nozzletics/adventtree26/(list of files, cad)

Other CAD files:
3mf_profiles/AdventTree_No_Locking.3mf
3mf_profiles/AdventTree_nozzletics.3mf
3d_model/AdventTree_No_Locking.blend
3d_model/AdventTree_nozzletics.blend
3d_model/latch.blend
