nozzletics/adventtree26/(commit log)

2026-10-25 Add Advent Tree Blender model and generator scripts
    Editable .blend model, latch part, and parametric generators for the hook
    and mech (cam drum + magnets) variants plus the stepper motor kit.
    README describes what is in the folder; STL/3MF exports and renders are
    not included and are exported from the .blend.
    [AdventTree_nozzletics.blend, latch.blend]
2026-10-25 Add technical drawings and part inventory
    Dimensioned views, section A-A and the part list with sizes and volumes.
    [AdventTree_Inventory.csv]
2026-10-25 Add assembly manual render scripts
    Blender scripts that set up the manual scene and render each figure with
    label anchor points. Output goes to ../manual relative to the .blend.
2026-10-25 Add assembly manual
    Assembly manual PDF with the rendered figures (f01-f21) and label positions.
2026-10-25 Add project README
    Describes the Advent Tree: how the drum-and-latch mechanism works, the mech,
    motor kit and hook variants, repository layout, working with the generator
    scripts in Blender, assembly overview and licensing.
2026-10-25 README: note that motor kit firmware is coming soon
2026-10-26 Add anti-turn screws and cap arrow to the mech tree
    Each tier joint gets a 45 deg hole for a countersunk 2 x 10 mm wood screw
    through the upper tray into the tube below, so a locked bayonet cannot turn
    loose; the top floor gets one in front of the dial dot. The cap gets a
    debossed arrow above box 1 that shows how to put it on.
    [AdventTree_nozzletics.blend]
2026-10-26 Add mini variant without the locking mechanism
    The mech tree scaled to 70 % with no drum, latches, knob, dial or detent.
    Boxes are held by the 6 x 3 magnets only. The script reuses
    advent_tree_mech.py from the same folder.
    [AdventTree_No_Locking.blend]
2026-10-26 Add 3MF print projects for the full-size and mini trees
    Bambu Studio projects with plates for AdventTree_nozzletics (mech) and
    AdventTree_No_Locking (mini).
    [AdventTree_No_Locking.3mf, AdventTree_nozzletics.3mf]
2026-10-26 Document the mini variant, 3MF projects and anti-turn screws
    Update both READMEs with the new files, the screw step in the assembly
    overview and the extra hardware.
